Marcoss53/esp32-lastik-sisirme/enclosure/renders/alt_hortum.png

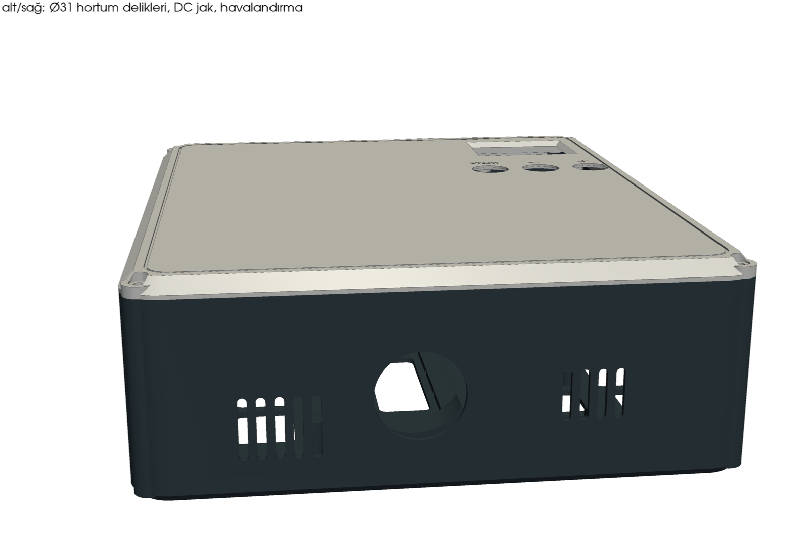
enclosure/renders/alt_hortum.png
