Marcoss53/esp32-lastik-sisirme/enclosure/renders/ic_izometrik_gelecek.png

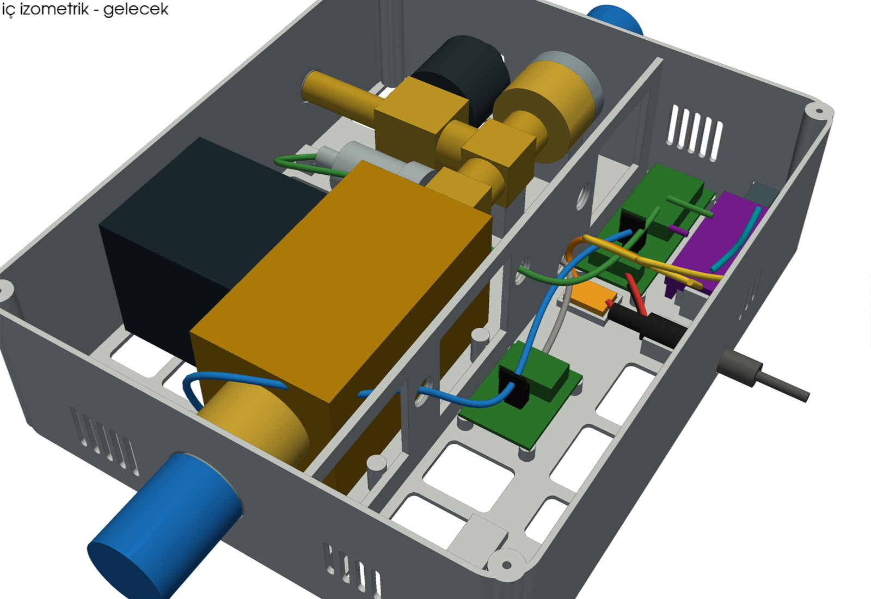
enclosure/renders/ic_izometrik_gelecek.png
