Marcoss53/esp32-lastik-sisirme/enclosure/renders/ic_yerlesim_gelecek.png

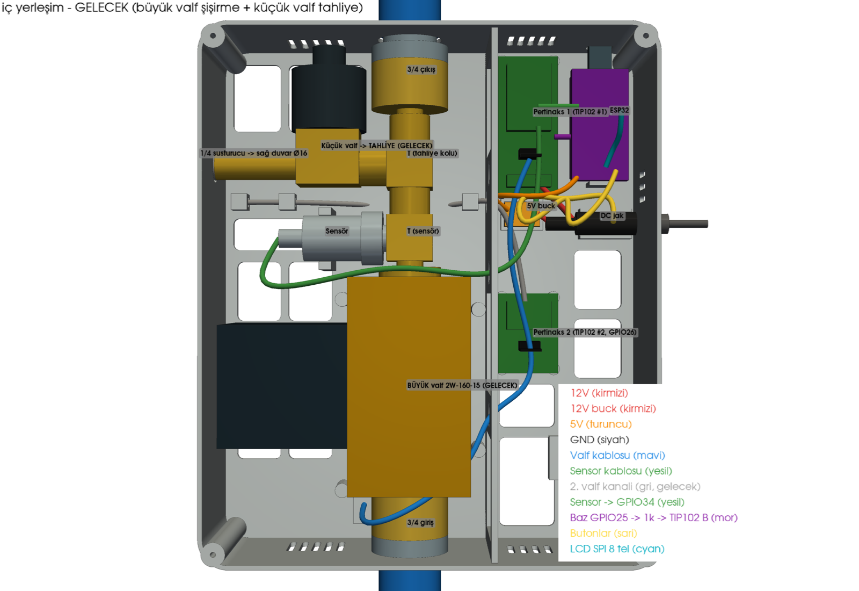
enclosure/renders/ic_yerlesim_gelecek.png
