Marcoss53/esp32-lastik-sisirme/enclosure/renders/ic_yerlesim_simdi.png

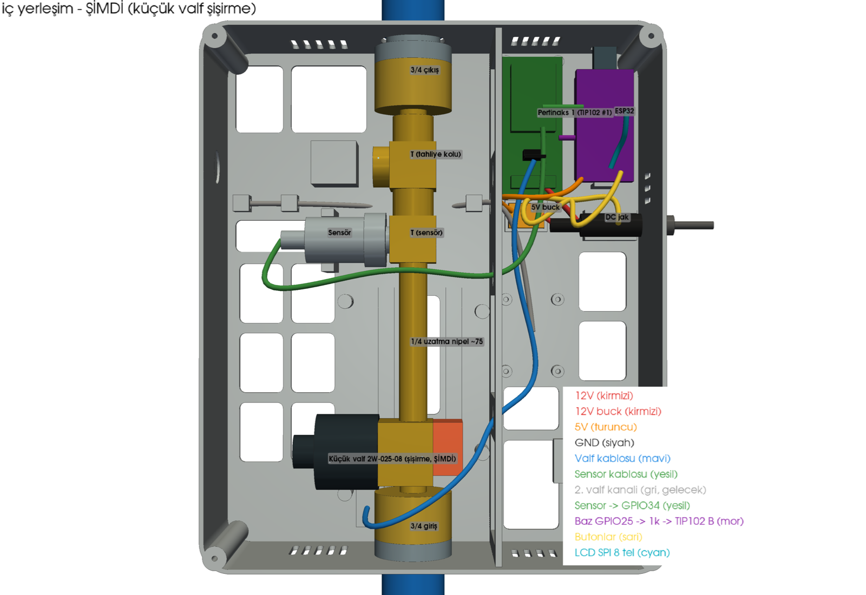
enclosure/renders/ic_yerlesim_simdi.png
