Marcoss53/esp32-lastik-sisirme/enclosure/renders/izometrik.png

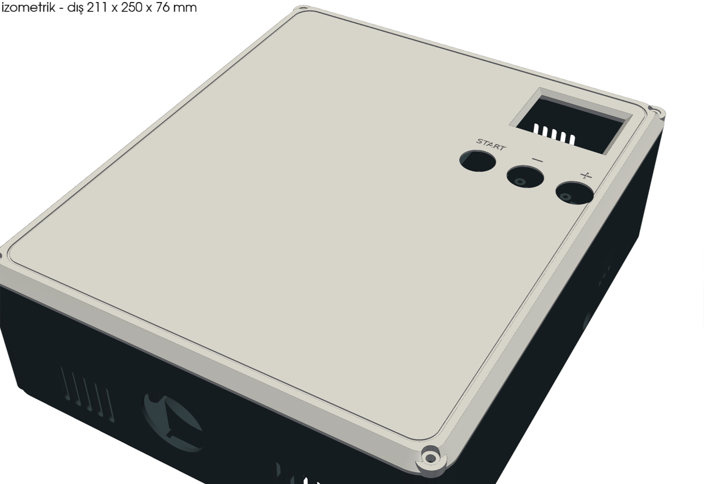
enclosure/renders/izometrik.png
