Marcoss53/esp32-lastik-sisirme/enclosure/renders/patlatilmis.png

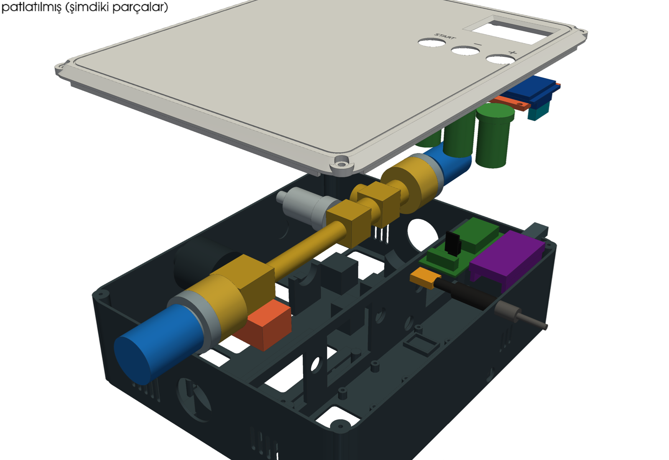
enclosure/renders/patlatilmis.png
