Marcoss53/esp32-lastik-sisirme/enclosure/3mf/plate2_lid_clamps_spacer_PLA.3mf

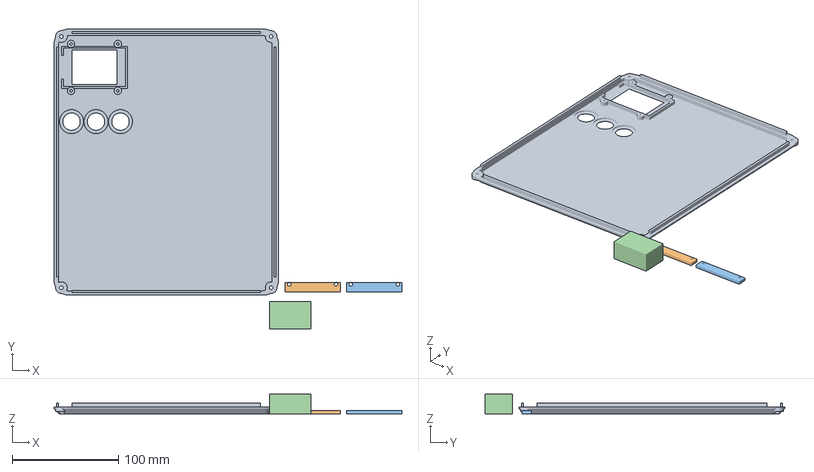
[picture p18: CAD file, 2026-10-25]
enclosure/3mf/plate2_lid_clamps_spacer_PLA.3mf
327.0 x 281.8 x 18.5 mm
kapak.stl
kelepce.stl
kelepce2.stl
takoz.stl
