Marcoss53/esp32-lastik-sisirme/enclosure/step/kelepce.step

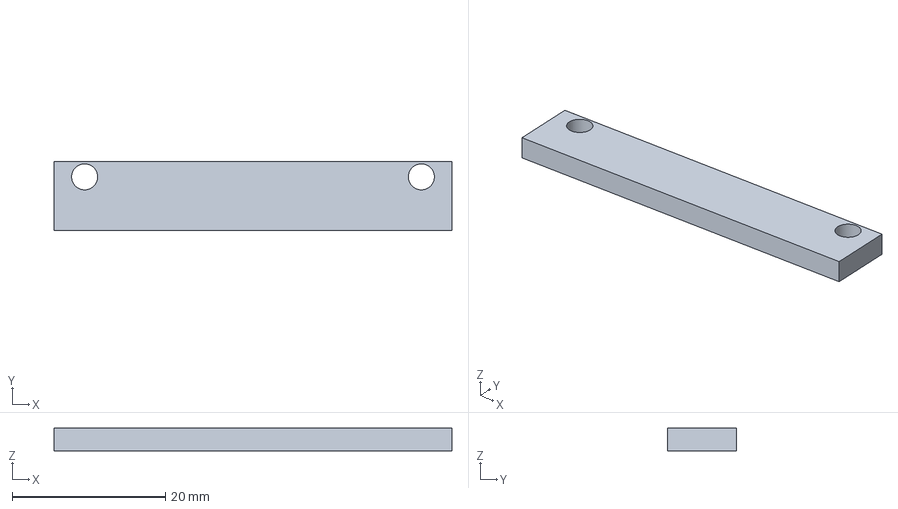
[picture p19: CAD file, 2026-10-25]
enclosure/step/kelepce.step
52.0 x 9.00 x 3.00 mm
