Marcoss53/esp32-lastik-sisirme/enclosure/stl/takoz.stl

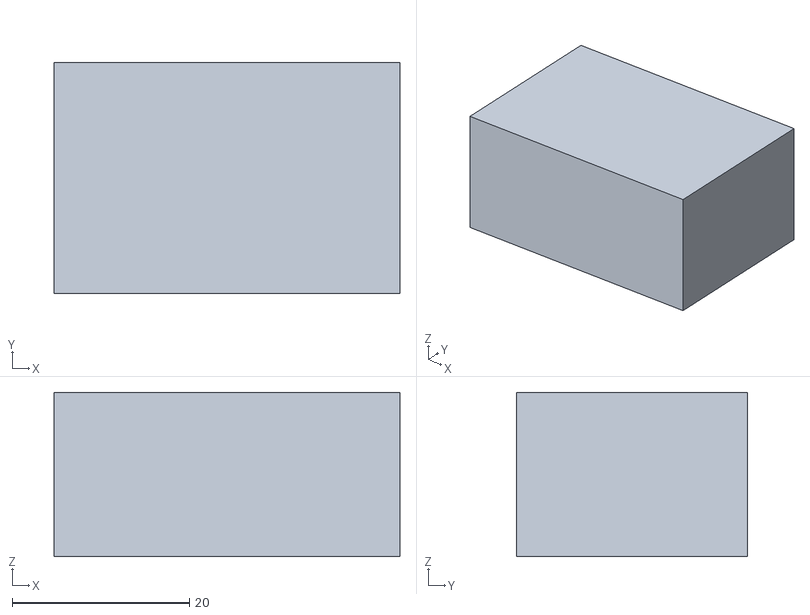
[picture p20: CAD file, 2026-10-25]
enclosure/stl/takoz.stl
39.0 x 26.0 x 18.5
