Marcoss53/esp32-lastik-sisirme/enclosure/3mf/plate1_body_PLA.3mf

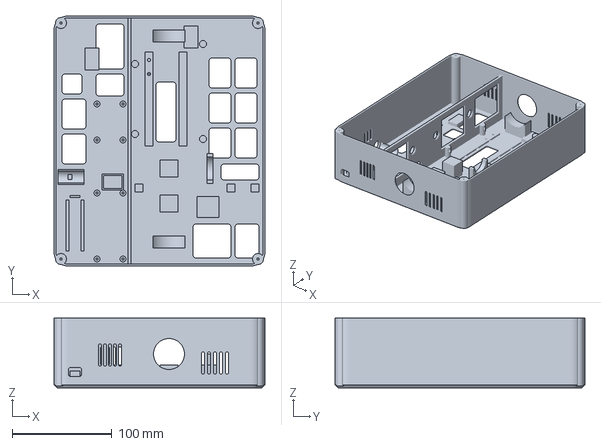
[picture p21: CAD file, 2026-10-25]
enclosure/3mf/plate1_body_PLA.3mf
211.0 x 250.0 x 70.0 mm
