Marcoss53/esp32-lastik-sisirme/enclosure/step/kapak.step

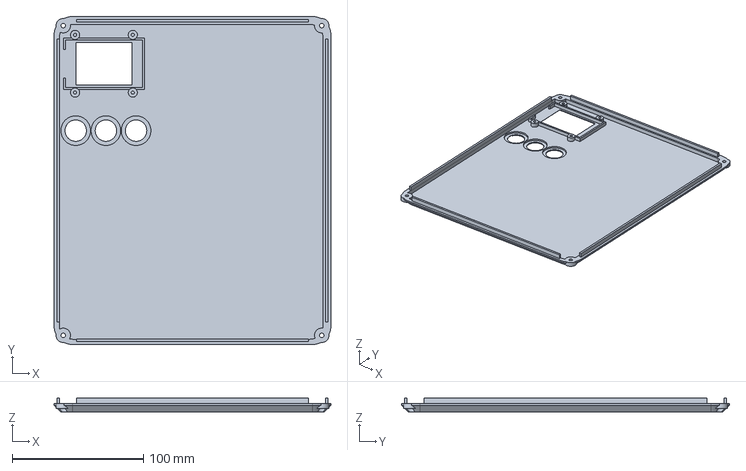
[picture p22: CAD file, 2026-10-25]
enclosure/step/kapak.step
211.0 x 250.0 x 10.4 mm
