Marcoss53/esp32-lastik-sisirme/(list of files, cad)

Other CAD files:
enclosure/step/govde.step
enclosure/stl/govde.stl
enclosure/stl/kapak.stl
enclosure/stl/kelepce.stl
