Marcoss53/esp32-lastik-sisirme/wiring/9_kutu_ici_3d_ustten.png

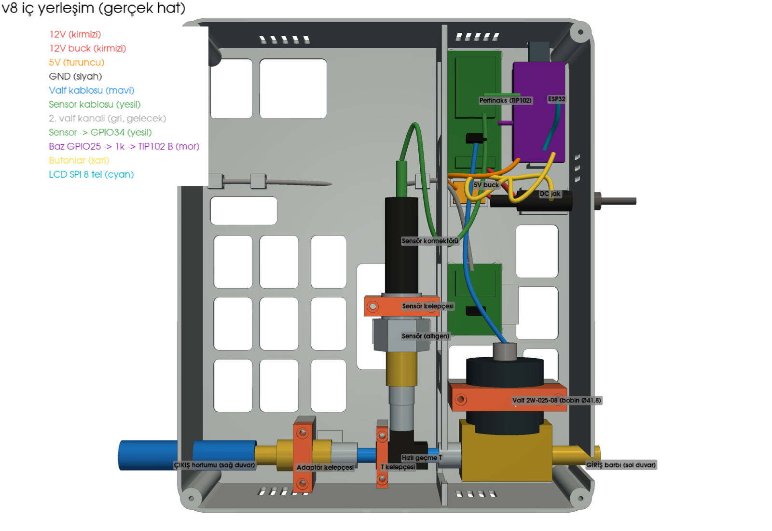
wiring/9_kutu_ici_3d_ustten.png
