Marcoss53/esp32-lastik-sisirme/wiring/8_KUTU_ICI_BAGLANTI.pdf

### PNÖMATİK BÖLME

### ELEKTRONİK BÖLME

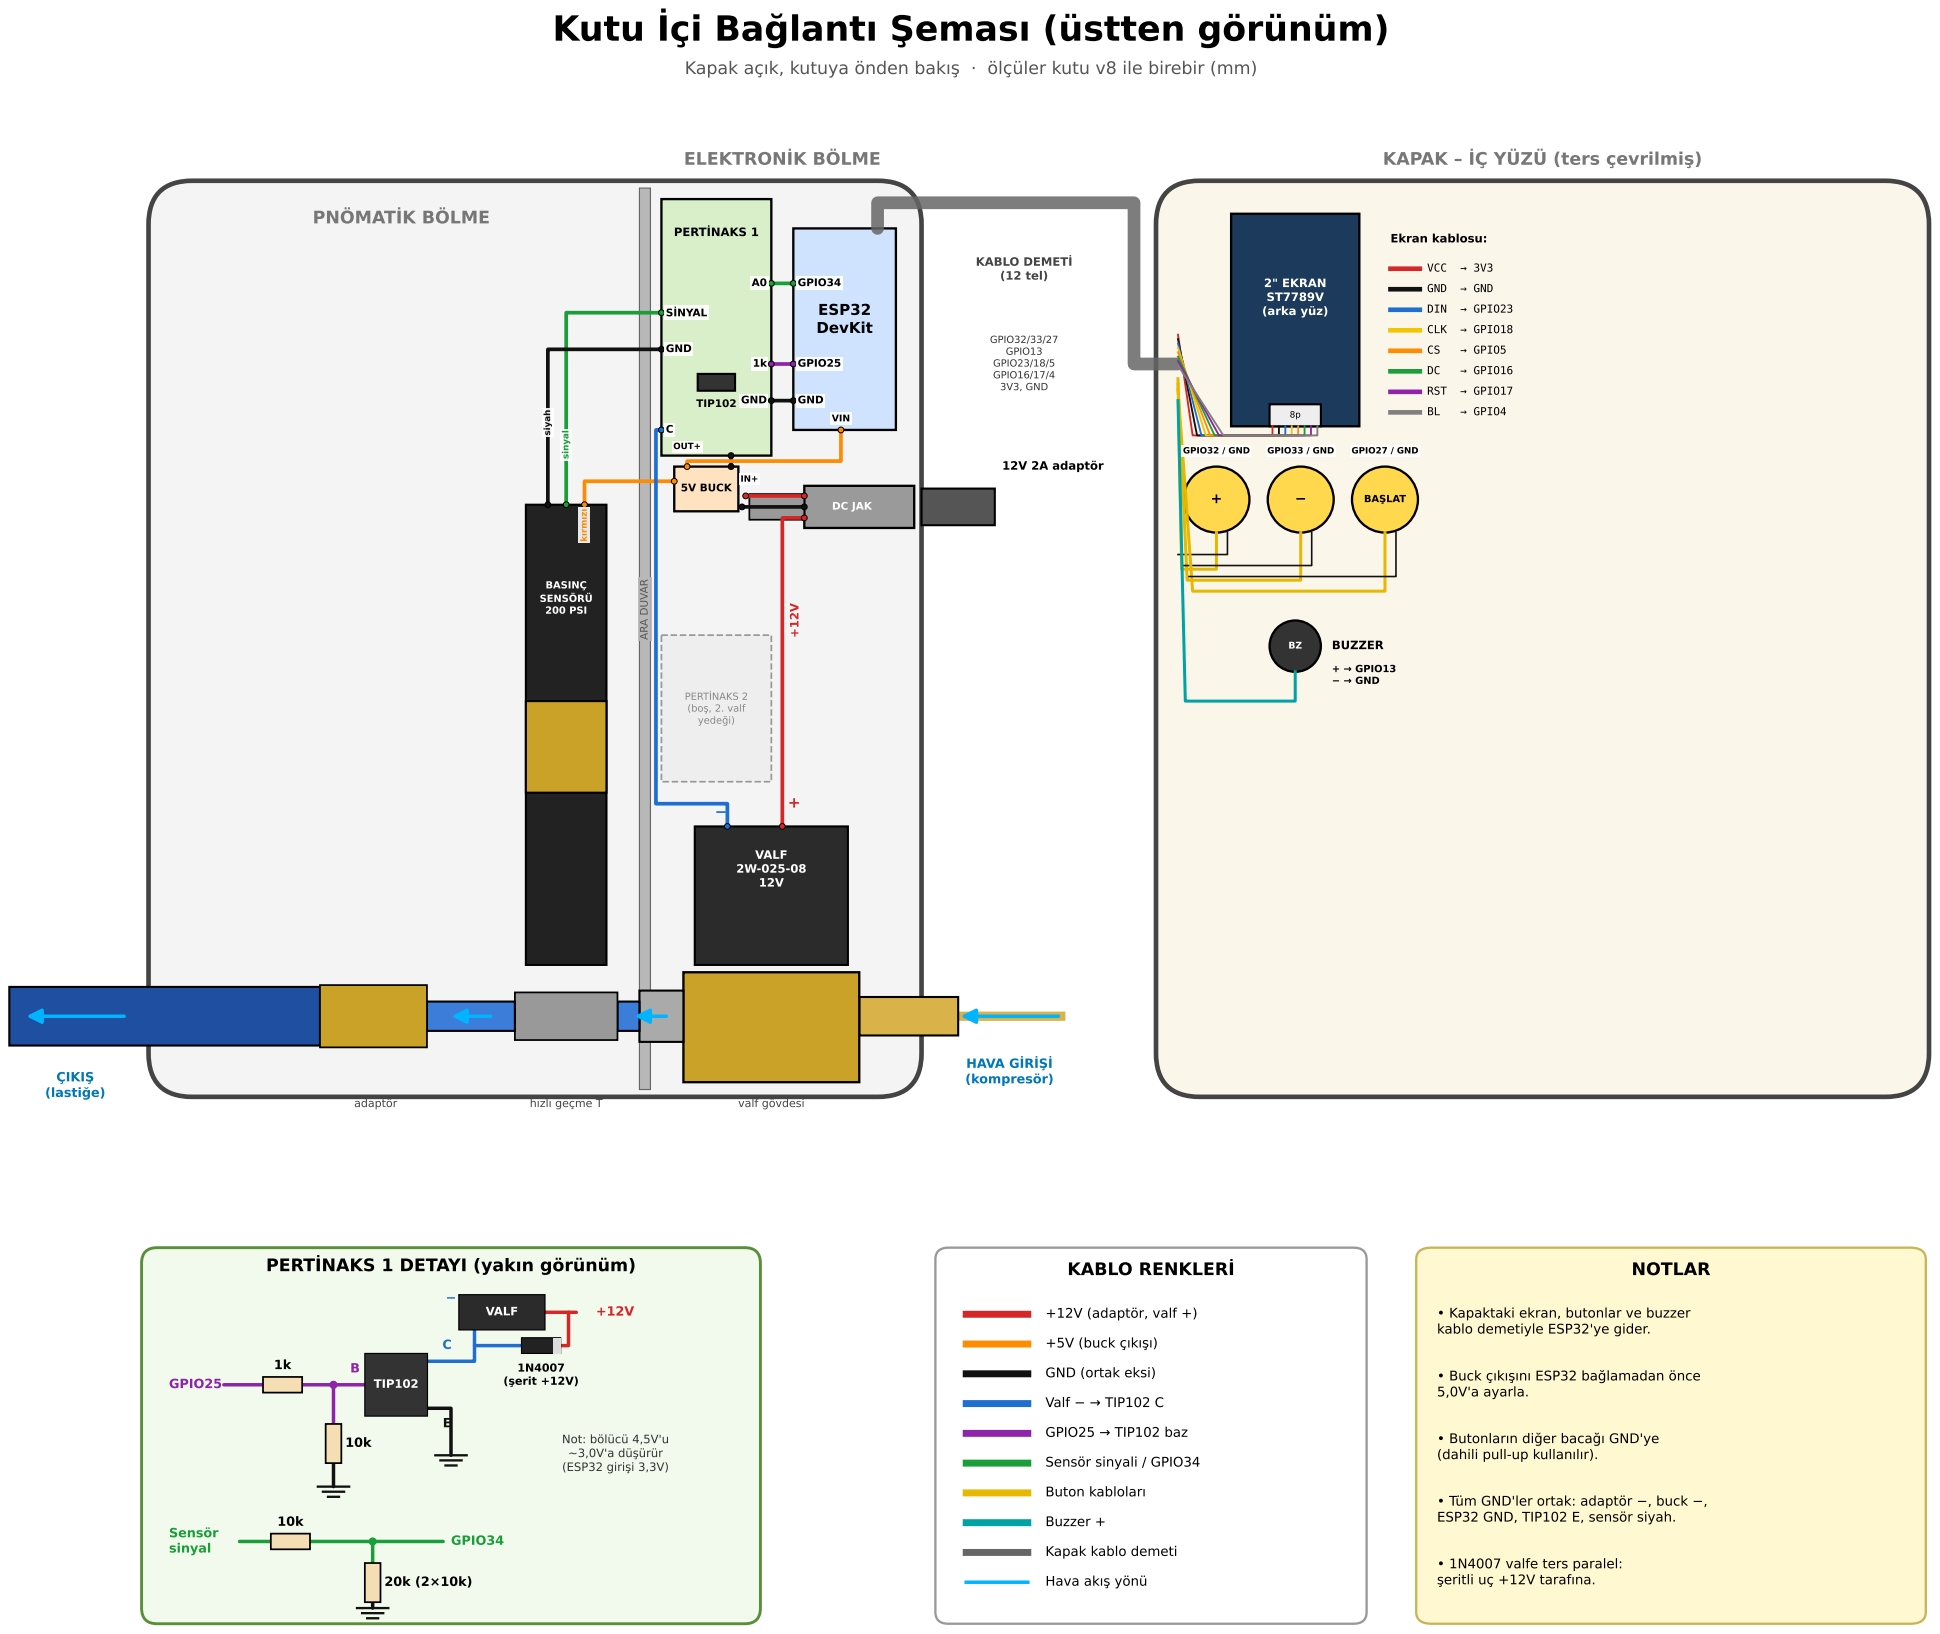
[picture p25: page 1]
ARA DUVAR; ESP32 DevKit; PERTİNAKS 1; TIP102; 5V BUCK; DC JAK; PERTİNAKS 2; (boş, 2.; valf; yedeği); 12V 2A adaptör; VALF 2W-025-08 12V; HAVA GİRİŞİ; ÇIKIŞ; (kompresör); (lastiğe); adaptör; hızlı geçme T; valf gövdesi; +⁺¹²V; GPIO34; GPIO25; GND; SİNYAL; VIN; OUT+; kırmızı; sinyal; siyah; 2" EKRAN ST7789V (arka yüz); BAŞLAT; BUZZER; GPIO32 / GND; GPIO33 / GND; GPIO27 / GND; + → GPIO13 − → GND; Ekran kablosu:; VCC → 3V3 GND → GND DIN → GPIO23 CLK → GPIO18; → GPIO5; → GPIO16; RST → GPIO17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

Kutu İçi Bağlantı Şeması (üstten görünüm)

Kapak açık, kutuya önden bakış · ölçüler kutu v8 ile birebir (mm)

KAPAK – İÇ YÜZÜ (ters çevrilmiş)

PERTİNAKS 1 DETAYI (yakın görünüm)

• Kapaktaki ekran, butonlar ve buzzer
kablo demetiyle ESP32'ye gider.

GND (ortak eksi)
Valf − → TIP102 C

• Buck çıkışını ESP32 bağlamadan önce
5,0V'a ayarla.

• Butonların diğer bacağı GND'ye
(dahili pull-up kullanılır).

• Tüm GND'ler ortak: adaptör −, buck −,
ESP32 GND, TIP102 E, sensör siyah.

Kapak kablo demeti
Hava akış yönü

• 1N4007 valfe ters paralel:
şeritli uç +12V tarafına.
