Marcoss53/esp32-lastik-sisirme/enclosure/petg.ini

bed_shape = 0x0,256x0,256x256,0x256
max_print_height = 256
nozzle_diameter = 0.4
filament_diameter = 1.75
layer_height = 0.28
first_layer_height = 0.28
perimeters = 2
top_solid_layers = 3
bottom_solid_layers = 3
fill_density = 8%
fill_pattern = gyroid
support_material = 0
temperature = 245
first_layer_temperature = 245
bed_temperature = 75
first_layer_bed_temperature = 75
filament_density = 1.27
filament_type = PETG
perimeter_speed = 200
external_perimeter_speed = 150
infill_speed = 250
solid_infill_speed = 200
top_solid_infill_speed = 150
first_layer_speed = 50
travel_speed = 500
gap_fill_speed = 150
bridge_speed = 50
default_acceleration = 6000
perimeter_acceleration = 5000
infill_acceleration = 8000
first_layer_acceleration = 500
travel_acceleration = 10000
machine_max_acceleration_extruding = 12000
machine_max_acceleration_x = 12000
machine_max_acceleration_y = 12000
machine_max_feedrate_x = 500
machine_max_feedrate_y = 500
max_volumetric_speed = 12
gcode_flavor = marlinfirmware
