Marcoss53/esp32-lastik-sisirme/firmware/src/panel.h

// src/panel_src.html dosyasından gzip ile üretildi (tools/panel_uret.py)
#pragma once
#include <pgmspace.h>
const uint8_t PANEL_GZ[] PROGMEM = {31,139,8,0,210,38,226,106,2,255,173,90,75,115,219,198,29,191,235,83,108,228,36,0,42,16,2,168,23,77,18,228,200,145,28,171,150,31,35,41,157,105,61,158,116,1,44,200,21,241,224,0,11,74,52,205,153,222,210,115,123,205,196,199,92,227,75,79,189,73,254,34,249,36,253,255,23,32,8,130,84,234,116,58,99,81,196,238,255,253,218,223,66,238,126,225,197,174,152,142,25,25,138,48,232,117,241,147,4,52,26,216,34,129,39,70,189,94,55,100,130,18,119,72,147,148,9,59,19,126,163,85,172,69,52,100,246,132,179,155,113,156,8,226,198,145,96,145,176,183,111,184,39,134,182,199,38,220,101,13,249,160,243,136,11,78,131,70,234,210,128,217,214,118,111,171,43,184,8,88,239,156,166,130,143,200,167,159,248,167,15,60,9,89,119,55,95,239,166,98,10,191,182,254,48,115,226,219,70,202,223,241,104,208,118,226,196,99,73,3,86,230,78,236,77,103,33,77,6,60,106,155,29,135,186,163,65,18,103,145,215,126,100,182,76,106,178,142,27,7,113,210,126,196,14,217,99,223,236,248,96,91,195,167,33,15,166,237,116,154,10,22,54,50,174,95,178,65,204,200,119,103,250,69,236,196,34,214,83,26,165,141,148,37,220,159,111,161,235,44,153,141,169,231,161,106,107,127,124,75,172,195,241,109,167,52,66,136,56,108,91,176,156,198,1,247,200,35,211,60,48,15,253,142,199,211,113,64,167,109,63,96,183,157,235,12,220,243,167,141,34,54,237,116,76,33,38,14,19,55,140,69,29,26,240,65,212,224,96,77,218,118,97,155,37,160,215,90,186,37,173,6,223,89,187,105,130,230,128,9,32,105,160,12,52,169,9,75,133,151,166,233,182,124,127,110,8,234,164,179,21,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
const size_t PANEL_GZ_LEN = 3757;
