Marcoss53/esp32-lastik-sisirme/(commit log)

2026-10-25 Initial release: ESP32 tire inflator firmware, enclosure, wiring, BOM
    [BOM.csv, govde.step, govde.stl, kapak.step, kapak.stl, kelepce.step, kelepce.stl, plate1_body_PLA.3mf]
2026-10-28 Görsel bağlantı şeması: tam sayfa, buzzer ve pnömatik eklendi
    [s.py]
